DynamixYANG/akg-k712-pro-repair/3d/k712_inserts.3mf

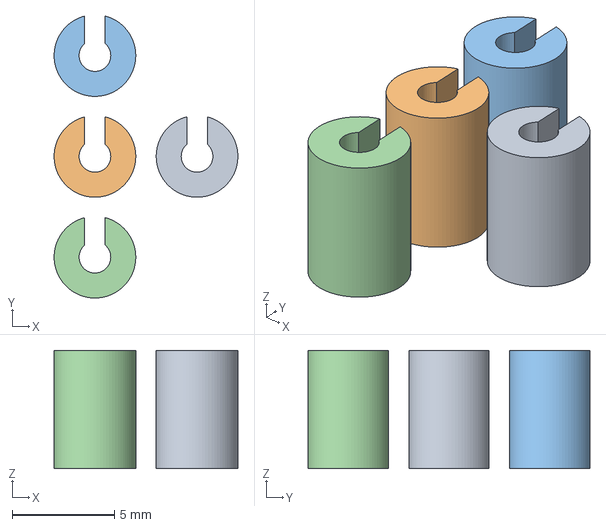
[picture p18: CAD file, 2026-10-11]
3d/k712_inserts.3mf
9.00 x 13.8 x 5.80 mm
