DynamixYANG/akg-k712-pro-repair/3d/k712pro_pin_v2.3mf

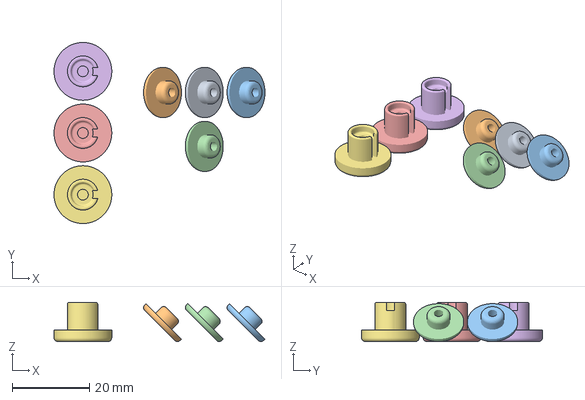
[picture p19: CAD file, 2026-10-11]
3d/k712pro_pin_v2.3mf
54.8 x 47.0 x 10.1 mm
k712pro_top x 3
