DynamixYANG/akg-k712-pro-repair/(commit log)

2026-10-11 AKG K712 PRO headband repair: photos, 3D models, README (CC BY-NC-SA 4.0)
    [k712_inserts.3mf, k712pro_pin_v2.3mf]
2026-10-11 Add hair-tie prep photo, M2x6 screw spec, clarify C-shaped spacers usage
